soramimi/jjysim/3dp/antenna/jjy-futa.stl

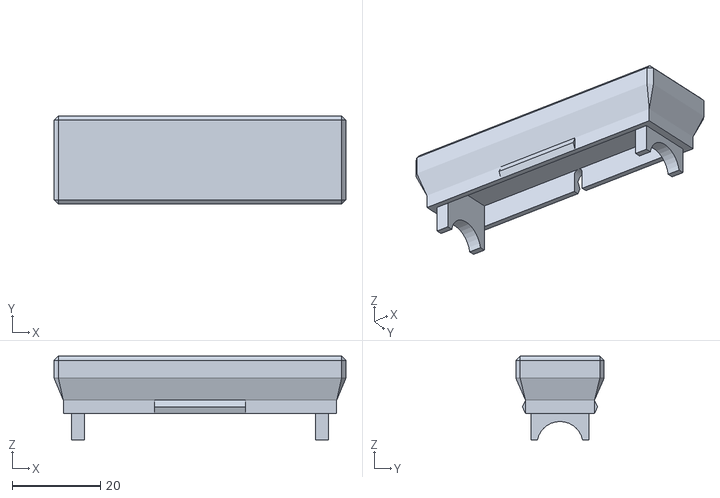
[picture p1: CAD file, 2026-10-03]
3dp/antenna/jjy-futa.stl
66.0 x 20.0 x 19.0
