soramimi/jjysim/3dp/kiban/kiban-futa.stl

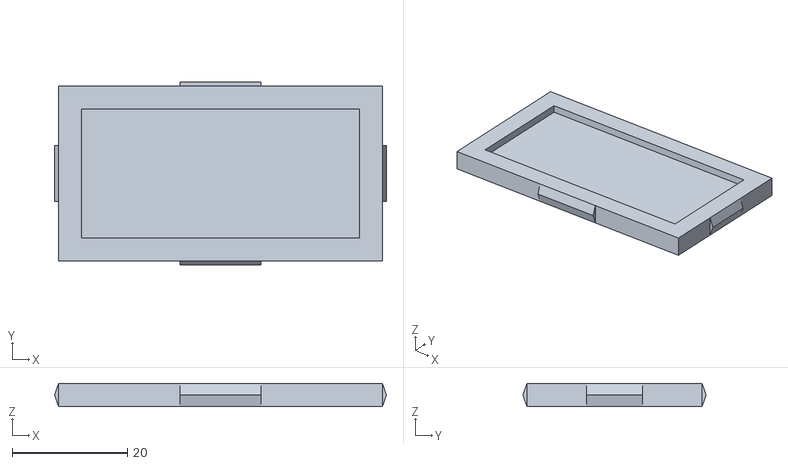
[picture p2: CAD file, 2026-10-03]
3dp/kiban/kiban-futa.stl
57.6 x 31.8 x 4.00
