soramimi/jjysim/3dp/antenna/jjy-hako.stl

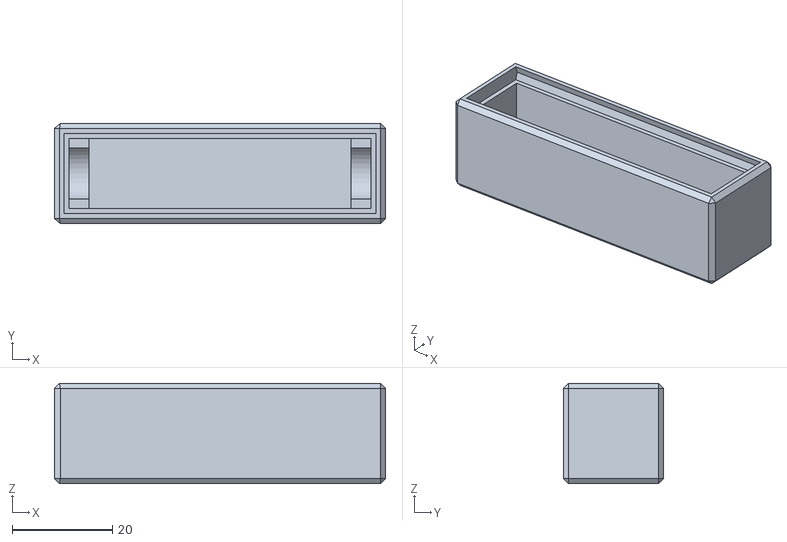
[picture p3: CAD file, 2026-10-03]
3dp/antenna/jjy-hako.stl
66.0 x 20.0 x 20.0
