soramimi/jjysim/3dp/kiban/kiban-hako.stl

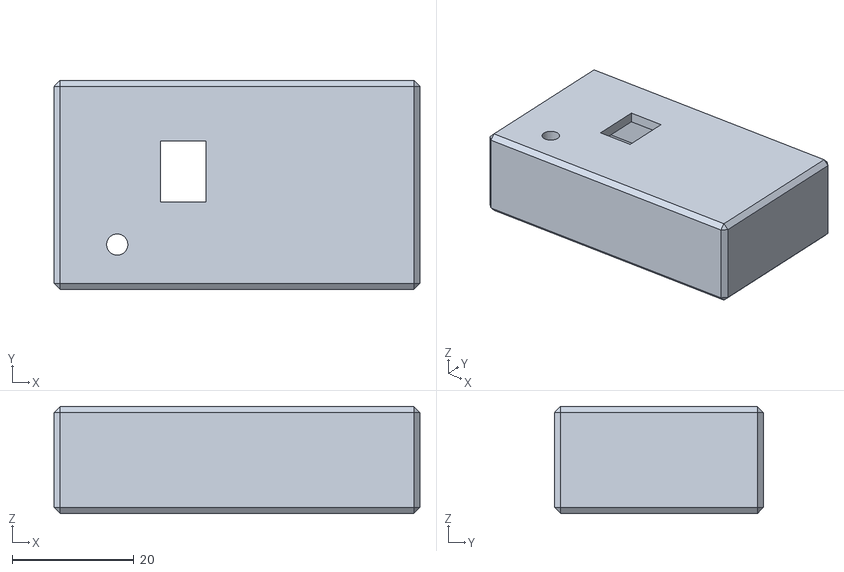
[picture p4: CAD file, 2026-10-03]
3dp/kiban/kiban-hako.stl
60.2 x 34.4 x 17.6
