soramimi/jjysim/(list of files, cad)

Other CAD files:
3dp/antenna/jjy-futa.blend
3dp/antenna/jjy-hako.blend
3dp/antenna/jjy.blend
3dp/kiban/kiban-futa.blend
3dp/kiban/kiban-hako.blend
3dp/kiban/kiban.blend
