soramimi/jjysim/pcb/jjysim.kicad_pcb

## KiCad design pcb/jjysim.kicad_pcb (2026-10-03)

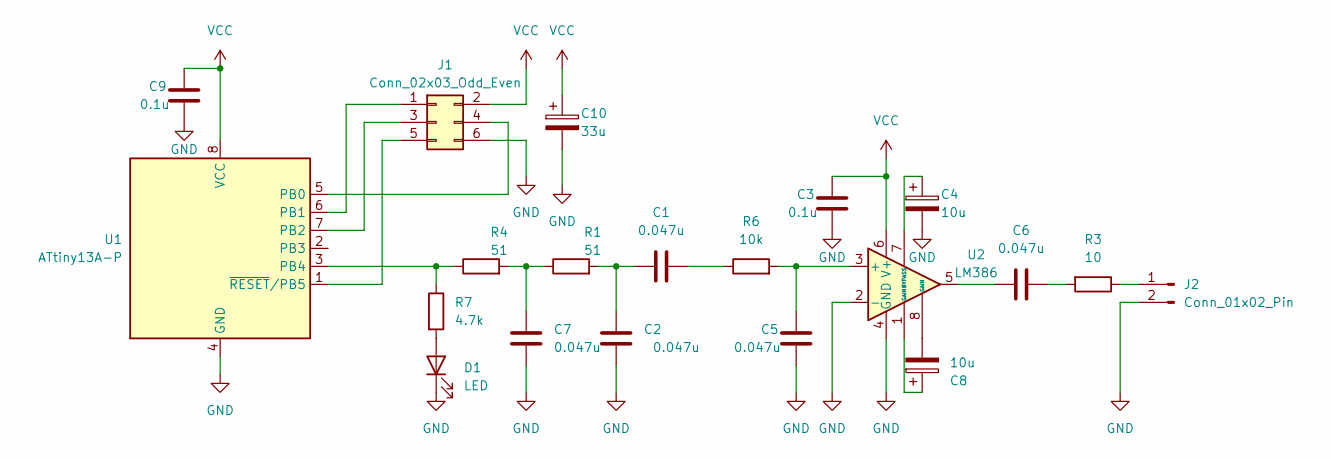
[picture p5: schematic jjysim.kicad_sch]

Parts:
C1, C2, C5, C6, C7: 0.047u; C_Disc_D7.5mm_W4.4mm_P5.00mm
C3, C9: 0.1u; C_Disc_D4.3mm_W1.9mm_P5.00mm
C4, C8: 10u; CP_Radial_Tantal_D5.0mm_P2.50mm
C10: 33u; CP_Radial_Tantal_D5.0mm_P2.50mm
D1: LED; LED_D3.0mm
J1: Conn_02x03_Odd_Even; PinHeader_2x03_P2.54mm_Vertical
J2: Conn_01x02_Pin; PinHeader_2x01_P2.54mm_Vertical
R1, R4: 51; R_Axial_DIN0204_L3.6mm_D1.6mm_P2.54mm_Vertical
R3: 10; R_Axial_DIN0204_L3.6mm_D1.6mm_P2.54mm_Vertical
R6: 10k; R_Axial_DIN0204_L3.6mm_D1.6mm_P2.54mm_Vertical
R7: 4.7k; R_Axial_DIN0204_L3.6mm_D1.6mm_P2.54mm_Vertical
U1: ATtiny13A-P; DIP-8_W7.62mm
U2: LM386; DIP-8_W7.62mm

Connections:
GND: C2.1, C3.1, C4.2, C5.1, C7.1, C9.1, C10.2, D1.1 (K), J1.6, J2.2, U1.4 (GND), U2.2 (-), U2.4 (GND)
unnamed: C1.1, C2.2, R1.2
unnamed: C1.2, R6.1
unnamed: C6.1, R3.2
unnamed: C6.2, U2.5
unnamed: C7.2, R1.1, R4.2
unnamed: C8.1, U2.1 (GAIN)
unnamed: C8.2, U2.8 (GAIN)
unnamed: D1.2 (A), R7.2
unnamed: J1.1, U1.6 (PB1)
unnamed: J1.3, U1.7 (PB2)
unnamed: J1.4, U1.5 (PB0)
unnamed: J1.5, U1.1 (~RESET/PB5)
unnamed: J2.1, R3.1
unnamed: R4.1, R7.1, U1.3 (PB4)
unnamed: C5.2, R6.2, U2.3 (+)
unnamed: C4.1, U2.7 (BYPASS)
VCC: C3.2, C9.2, C10.1, J1.2, U1.8 (VCC), U2.6 (V+)

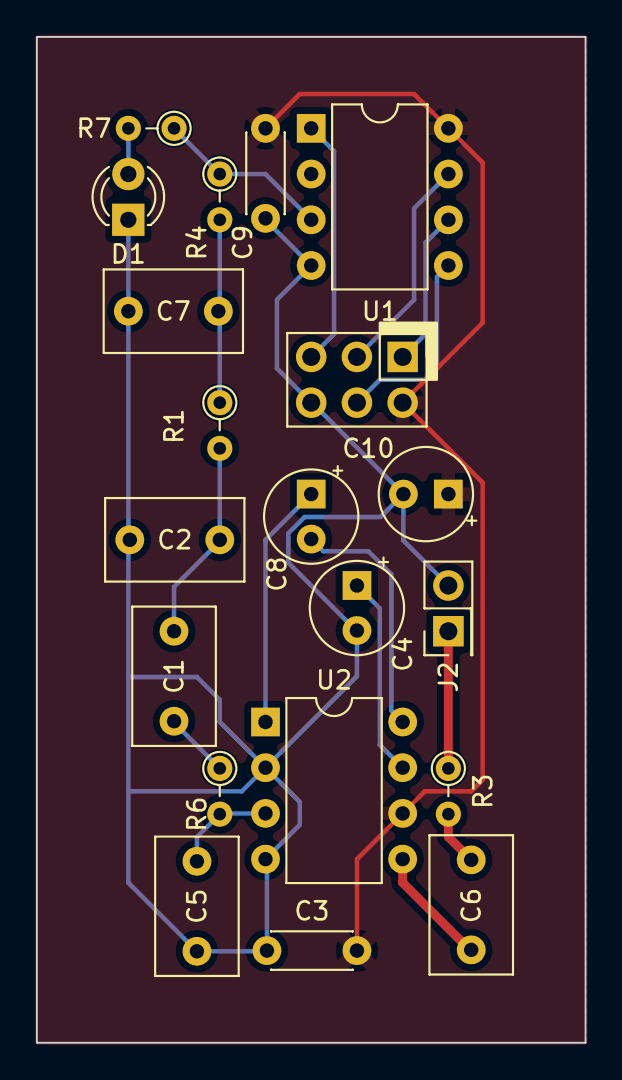
[picture p6: board jjysim.kicad_pcb from above]

Board: 2 copper layers, 30.5 x 55.9 mm, 20 parts (0 on the bottom side), 18 nets.
